voc/tallylight-v2/hardware/TallyLight.kicad_pcb

## KiCad design hardware/TallyLight.kicad_pcb (2026-01-03)

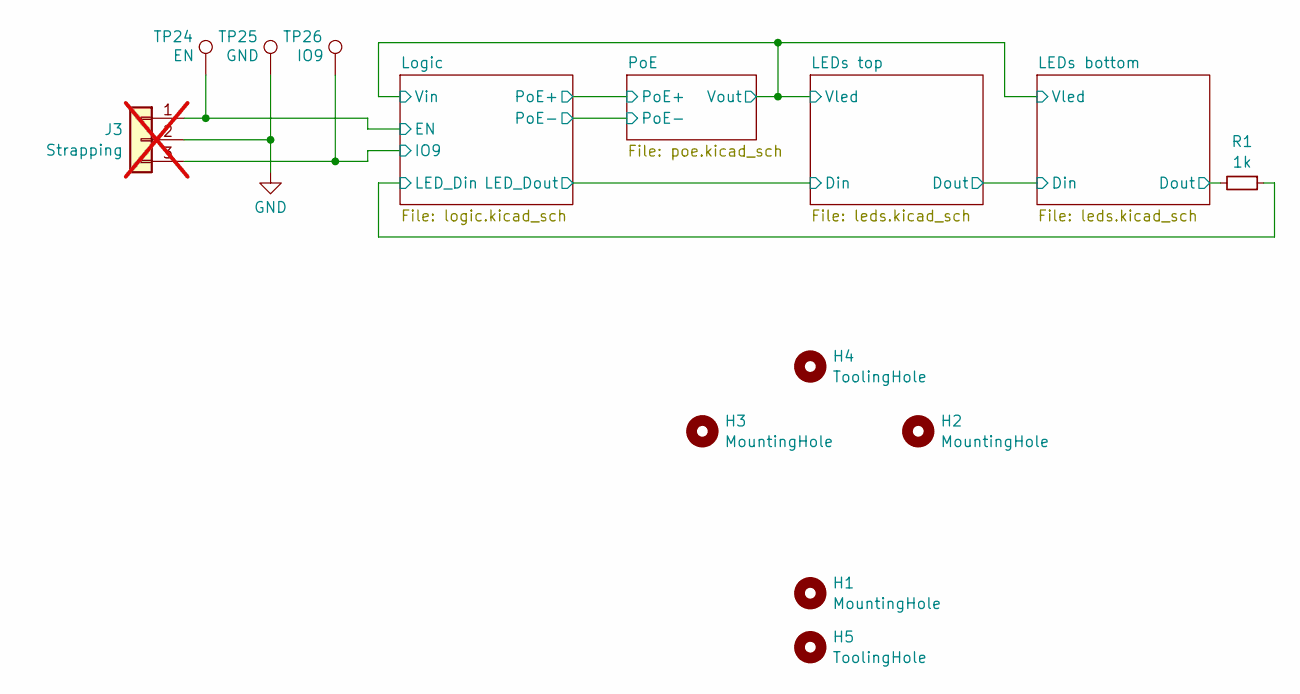
[picture p1: schematic TallyLight.kicad_sch]

Parts:
H1, H2, H3: MountingHole; MountingHole_3.2mm_M3
H4, H5: ToolingHole; ToolingHole_JLCSMT
J3: Strapping; PinHeader_1x03_P2.54mm_Vertical; not fitted
R1: 1k; R_0402_1005Metric; LCSC C11702
TP24: EN; TestPoint_Pad_D2.0mm_no_outline
TP25: GND; TestPoint_Pad_D2.0mm
TP26: IO9; TestPoint_Pad_D2.0mm_no_outline

Connections:
/LEDs bottom/Dout: R1.2; also elsewhere on the board
/Logic/EN: J3.1, TP24.1; also elsewhere on the board
/Logic/IO9: J3.3, TP26.1; also elsewhere on the board
/Logic/LED_Din: R1.1; also elsewhere on the board
GND: J3.2, TP25.1; also elsewhere on the board

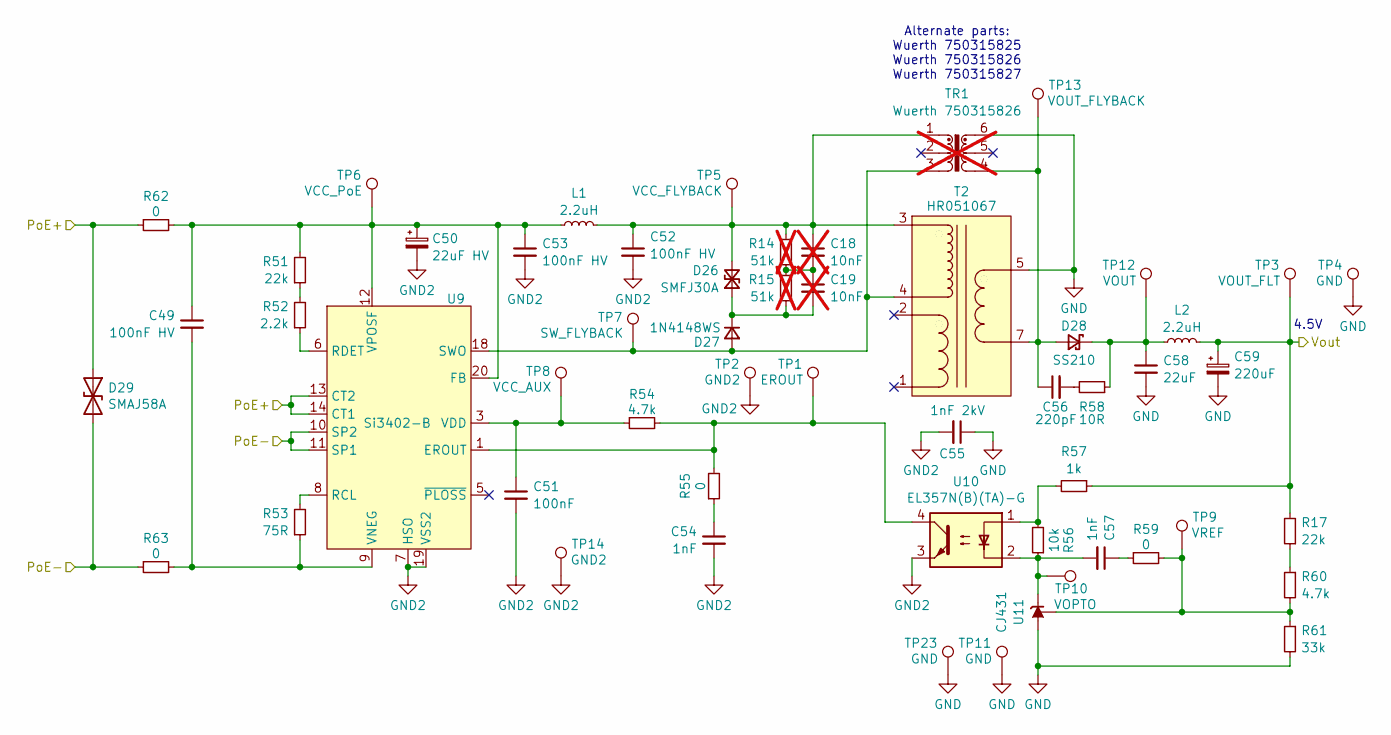
[picture p2: schematic poe.kicad_sch]

Parts:
C18, C19: 10nF; C_0402_1005Metric; LCSC C15195; not fitted
C49, C52, C53: 100nF HV; C_0805_2012Metric; LCSC C28233
C50: 22uF HV; CP_Elec_6.3x7.7; LCSC C344075
C51: 100nF; C_0402_1005Metric; LCSC C1525
C54, C57: 1nF; C_0402_1005Metric; LCSC C1523
C55: 1nF 2kV; C_1206_3216Metric; LCSC C9196
C56: 220pF; C_0402_1005Metric; LCSC C1530
C58: 22uF; C_0805_2012Metric; LCSC C45783
C59: 220uF; CP_Elec_6.3x7.7; LCSC C5243829
D26: SMFJ30A; D_SOD-123F; LCSC C151895
D27: 1N4148WS; D_SOD-323; LCSC C2128
D28: SS210; D_SMA; LCSC C14996
D29: SMAJ58A; D_SMA; LCSC C2980408
L1, L2: 2.2uH; L_1008_2520Metric; LCSC C964122
R14, R15: 51k; R_0402_1005Metric; LCSC C25794; not fitted
R17, R51: 22k; R_0402_1005Metric; LCSC C25768
R52: 2.2k; R_0402_1005Metric; LCSC C25879
R53: 75R; R_0603_1608Metric; LCSC C23242
R54, R60: 4.7k; R_0402_1005Metric; LCSC C25900
R55, R59, R62, R63: 0; R_0402_1005Metric; LCSC C17168
R56: 10k; R_0402_1005Metric; LCSC C25744
R57: 1k; R_0402_1005Metric; LCSC C11702
R58: 10R; R_0402_1005Metric; LCSC C25077
R61: 33k; R_0402_1005Metric; LCSC C25779
T2: HR051067; LCSC C93830
TP1: EROUT; TestPoint_Pad_D2.0mm_no_outline
TP2, TP14: GND2; TestPoint_Pad_D2.0mm_trianglular_outline
TP3: VOUT_FLT; TestPoint_Pad_D2.0mm_no_outline
TP4, TP11, TP23: GND; TestPoint_Pad_D2.0mm
TP5: VCC_FLYBACK; TestPoint_Pad_D2.0mm_no_outline
TP6: VCC_PoE; TestPoint_Pad_D2.0mm_no_outline
TP7: SW_FLYBACK; TestPoint_Pad_D2.0mm_no_outline
TP8: VCC_AUX; TestPoint_Pad_D2.0mm_no_outline
TP9: VREF; TestPoint_Pad_D2.0mm_no_outline
TP10: VOPTO; TestPoint_Pad_D2.0mm_no_outline
TP12: VOUT; TestPoint_Pad_D2.0mm_no_outline
TP13: VOUT_FLYBACK; TestPoint_Pad_D2.0mm_no_outline
TR1: Wuerth 750315826; Transformer_Wuerth_750315371; not fitted
U9: Si3402-B; QFN-20-1EP_5x5mm_P0.8mm_EP2.7x2.7mm; LCSC C510771
U10: EL357N(B)(TA)-G; PC817CS_SMD; LCSC C20612591
U11: CJ431; SOT-23; LCSC C3113

Connections:
/LEDs bottom/Vled: C59.1, L2.2, R17.2, R57.1, TP3.1; also elsewhere on the board
/Logic/PoE+: D29.1 (A1), R62.1, U9.13 (CT2), U9.14 (CT1); also elsewhere on the board
/Logic/PoE-: D29.2 (A2), R63.1, U9.10 (SP2), U9.11 (SP1); also elsewhere on the board
GND: C55.1, C58.2, C59.2, R61.2, T2.5, T2.6, TP4.1, TP11.1, TP23.1, TR1.6, U11.3 (A); also elsewhere on the board
GND2: C50.2, C51.2, C52.2, C53.2, C54.2, C55.2, TP2.1, TP14.1, U9.7 (HSO), U9.19 (VSS2), U10.3
unnamed: C18.2, C19.1, R14.1, R15.2
unnamed: C49.2, R53.1, R63.2, U9.9 (VNEG), U9.21 (VNEG)
unnamed: C54.1, R55.1
unnamed: C56.2, R58.2
unnamed: C57.1, R59.1
unnamed: C19.2, D26.1 (A1), D27.1 (K), R15.1
unnamed: C18.1, C52.1, D26.2 (A2), L1.2, R14.2, T2.3, TP5.1, TR1.1
unnamed: D27.2 (A), T2.4, TP7.1, TR1.3, U9.18 (SWO)
unnamed: C56.1, D28.2 (A), T2.7, T2.8, TP13.1, TR1.4
unnamed: C58.1, D28.1 (K), L2.1, R58.1, TP12.1
unnamed: R17.1, R60.1
unnamed: R51.1, R52.2
unnamed: R56.2, R57.2, U10.1
unnamed: R54.2, R55.2, TP1.1, U9.1 (EROUT), U10.4
unnamed: C49.1, C50.1, C53.1, L1.1, R51.2, R62.2, TP6.1, U9.12 (VPOSF), U9.20 (FB)
unnamed: R53.2, U9.8 (RCL)
unnamed: R52.1, U9.6 (RDET)
unnamed: C51.1, R54.1, TP8.1, U9.3 (VDD)
unnamed: C57.2, R56.1, TP10.1, U10.2, U11.2 (K)
unnamed: R59.2, R60.2, R61.1, TP9.1, U11.1 (REF)

Notes on the sheet:
4.5V
Alternate parts: Wuerth 750315825 Wuerth 750315826 Wuerth 750315827

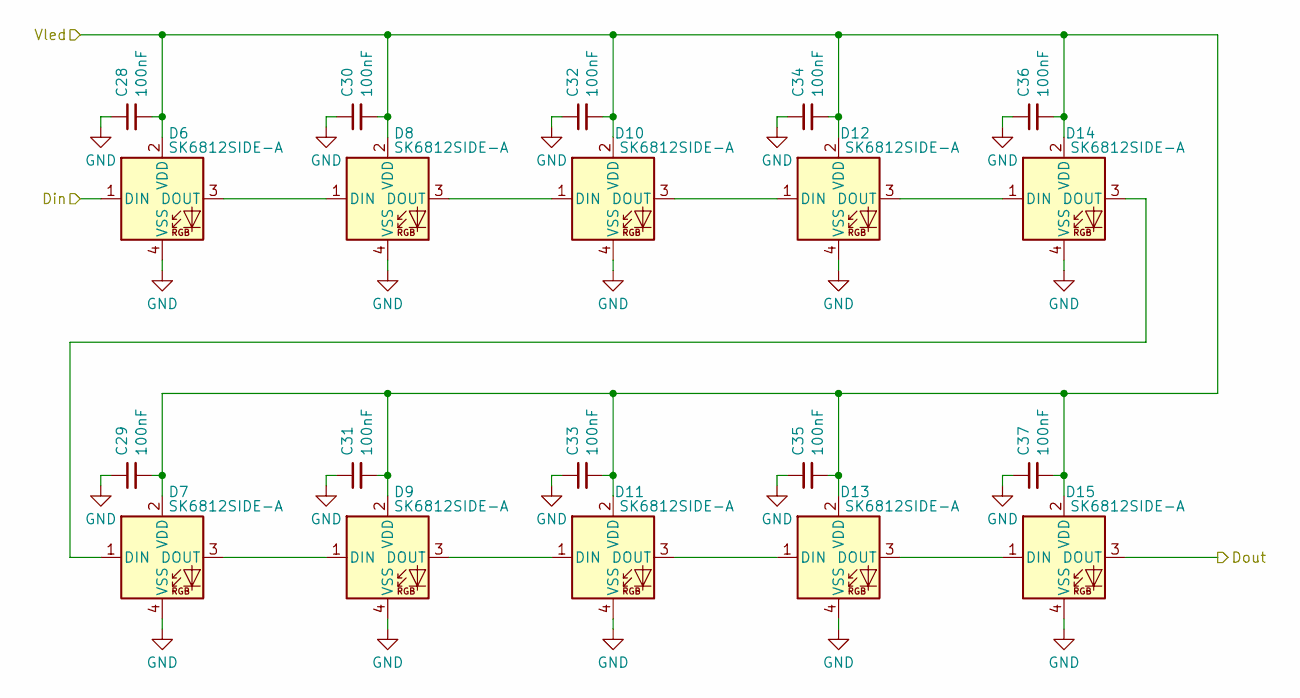
[picture p3: schematic leds.kicad_sch]

Parts:
C28, C29, C30, C31, C32, C33, C34, C35, C36, C37: 100nF; C_0402_1005Metric; LCSC C1525
D6, D7, D8, D9, D10, D11, D12, D13, D14, D15: SK6812SIDE-A; LED_SK6812SIDE-A; LCSC C5378721

Connections:
/LEDs bottom/Din: D15.3 (DOUT); also elsewhere on the board
/LEDs bottom/Vled: C28.2, C29.2, C30.2, C31.2, C32.2, C33.2, C34.2, C35.2, C36.2, C37.2, D6.2 (VDD), D7.2 (VDD), D8.2 (VDD), D9.2 (VDD), D10.2 (VDD), D11.2 (VDD), D12.2 (VDD), D13.2 (VDD), D14.2 (VDD), D15.2 (VDD); also elsewhere on the board
/LEDs top/Din: D6.1 (DIN); also elsewhere on the board
GND: C28.1, C29.1, C30.1, C31.1, C32.1, C33.1, C34.1, C35.1, C36.1, C37.1, D6.4 (VSS), D7.4 (VSS), D8.4 (VSS), D9.4 (VSS), D10.4 (VSS), D11.4 (VSS), D12.4 (VSS), D13.4 (VSS), D14.4 (VSS), D15.4 (VSS); also elsewhere on the board
unnamed: D6.3 (DOUT), D8.1 (DIN)
unnamed: D7.3 (DOUT), D9.1 (DIN)
unnamed: D8.3 (DOUT), D10.1 (DIN)
unnamed: D10.3 (DOUT), D12.1 (DIN)
unnamed: D9.3 (DOUT), D11.1 (DIN)
unnamed: D11.3 (DOUT), D13.1 (DIN)
unnamed: D12.3 (DOUT), D14.1 (DIN)
unnamed: D13.3 (DOUT), D15.1 (DIN)
unnamed: D7.1 (DIN), D14.3 (DOUT)

Parts of its further copies:
C38, C39, C40, C41, C42, C43, C44, C45, C46, C47: 100nF; C_0402_1005Metric; LCSC C1525
D16, D17, D18, D19, D20, D21, D22, D23, D24, D25: SK6812SIDE-A; LED_SK6812SIDE-A; LCSC C5378721

Connections of its further copies:
/LEDs bottom/Din: D16.1 (DIN); also elsewhere on the board
/LEDs bottom/Dout: D25.3 (DOUT); also elsewhere on the board
/LEDs bottom/Vled: C38.2, C39.2, C40.2, C41.2, C42.2, C43.2, C44.2, C45.2, C46.2, C47.2, D16.2 (VDD), D17.2 (VDD), D18.2 (VDD), D19.2 (VDD), D20.2 (VDD), D21.2 (VDD), D22.2 (VDD), D23.2 (VDD), D24.2 (VDD), D25.2 (VDD); also elsewhere on the board
GND: C38.1, C39.1, C40.1, C41.1, C42.1, C43.1, C44.1, C45.1, C46.1, C47.1, D16.4 (VSS), D17.4 (VSS), D18.4 (VSS), D19.4 (VSS), D20.4 (VSS), D21.4 (VSS), D22.4 (VSS), D23.4 (VSS), D24.4 (VSS), D25.4 (VSS); also elsewhere on the board
unnamed: D16.3 (DOUT), D18.1 (DIN)
unnamed: D17.1 (DIN), D24.3 (DOUT)
unnamed: D17.3 (DOUT), D19.1 (DIN)
unnamed: D18.3 (DOUT), D20.1 (DIN)
unnamed: D19.3 (DOUT), D21.1 (DIN)
unnamed: D20.3 (DOUT), D22.1 (DIN)
unnamed: D21.3 (DOUT), D23.1 (DIN)
unnamed: D22.3 (DOUT), D24.1 (DIN)
unnamed: D23.3 (DOUT), D25.1 (DIN)

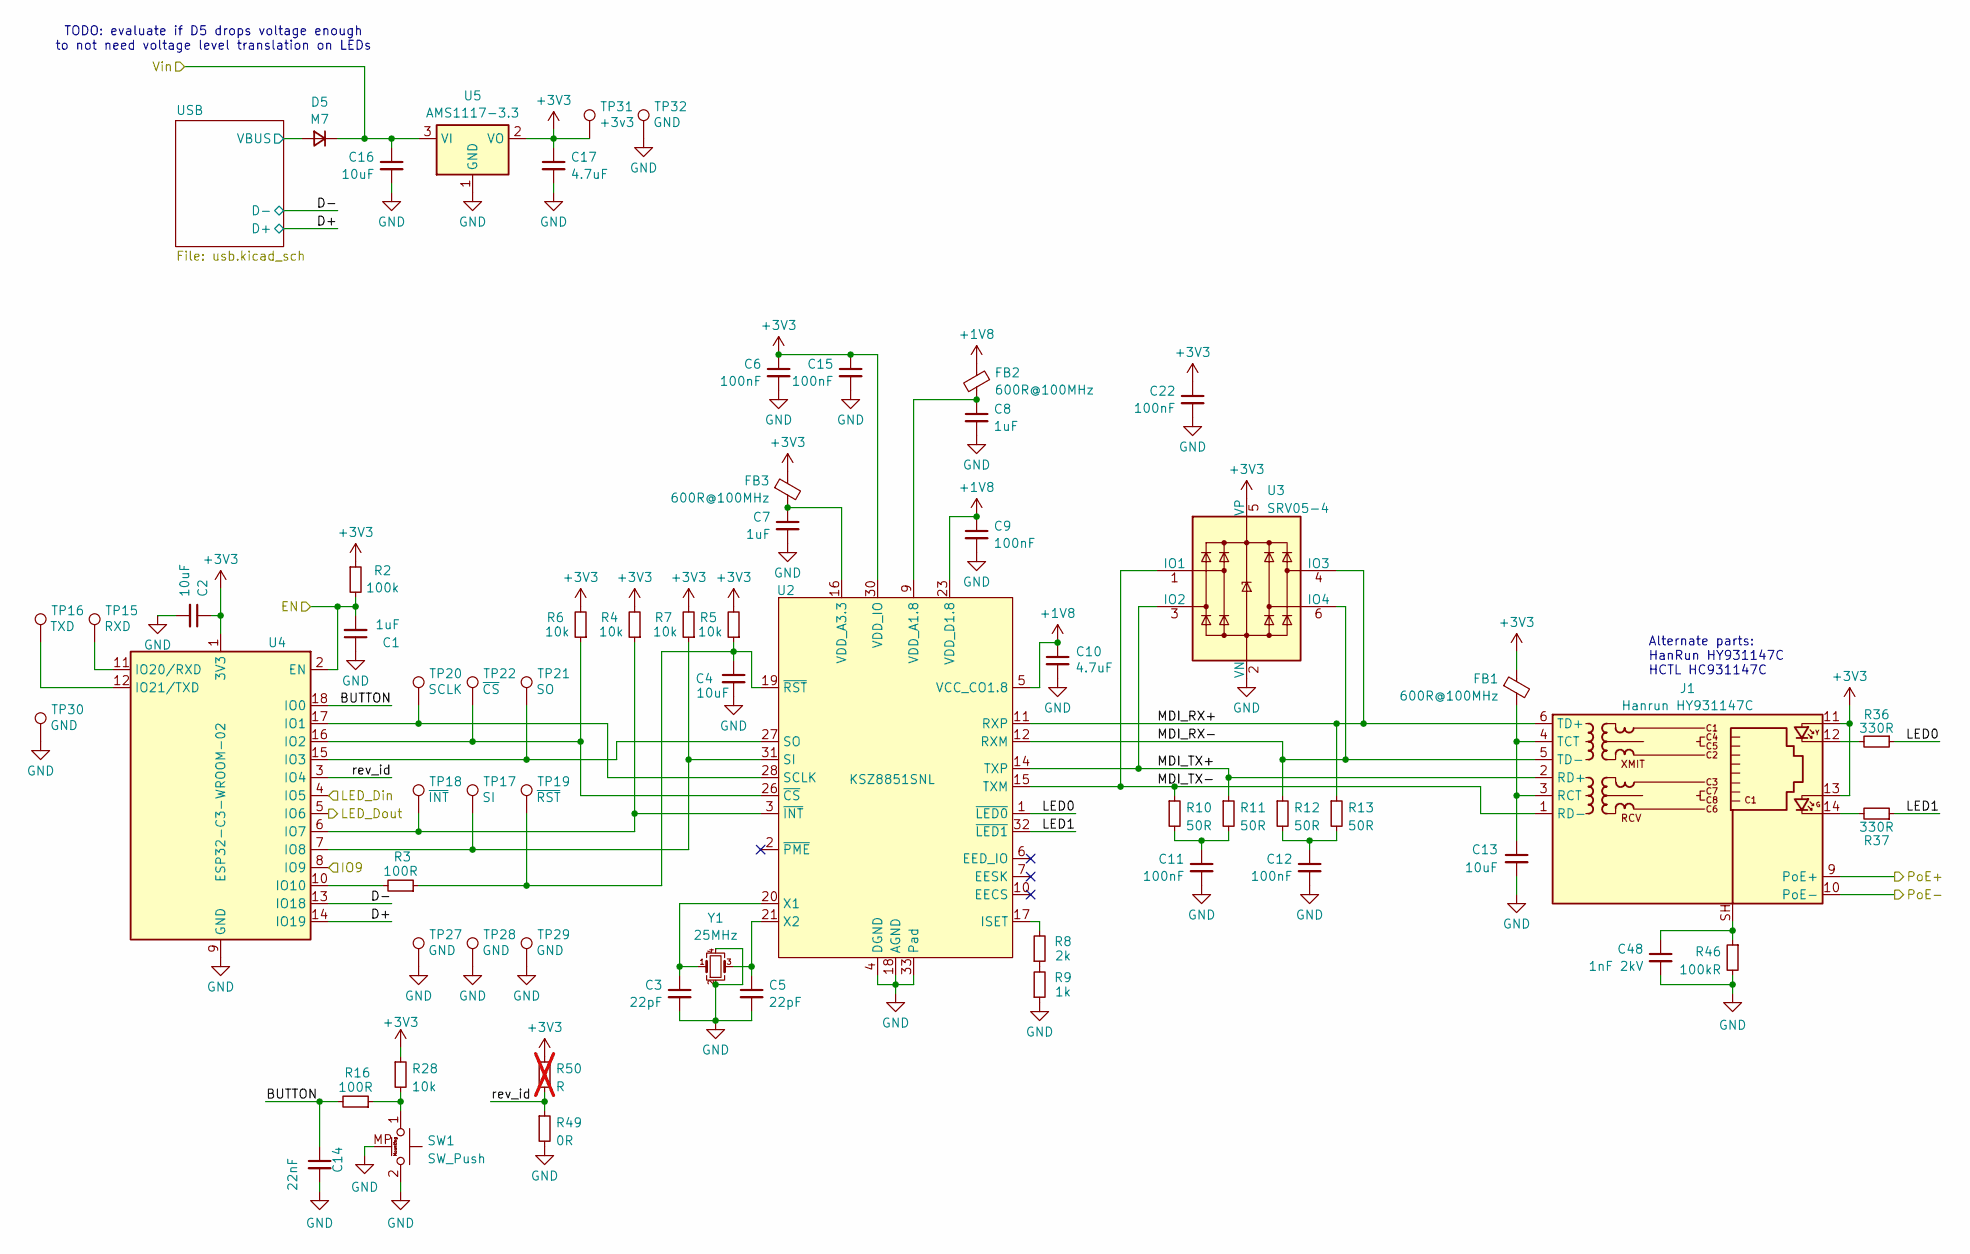
[picture p4: schematic logic.kicad_sch]

Parts:
C1, C7, C8: 1uF; C_0402_1005Metric; LCSC C52923
C2, C4, C13: 10uF; C_0402_1005Metric; LCSC C15525
C3, C5: 22pF; C_0402_1005Metric; LCSC C1555
C6, C9, C11, C12, C15, C22: 100nF; C_0402_1005Metric; LCSC C1525
C10, C17: 4.7uF; C_0402_1005Metric; LCSC C23733
C14: 22nF; C_0402_1005Metric; LCSC C1532
C16: 10uF; C_0603_1608Metric; LCSC C96446
C48: 1nF 2kV; C_1206_3216Metric; LCSC C9196
D5: M7; D_SMA; LCSC C95872
FB1, FB2, FB3: 600R@100MHz; L_0402_1005Metric; LCSC C76884
J1: Hanrun HY931147C; RJ45_Hanrun_HY931147C_Horizontal; LCSC C3021372
R2: 100k; R_0402_1005Metric; LCSC C25741
R3, R16: 100R; R_0402_1005Metric; LCSC C25076
R4, R5, R6, R7, R28: 10k; R_0402_1005Metric; LCSC C25744
R8: 2k; R_0402_1005Metric; LCSC C4109
R9: 1k; R_0402_1005Metric; LCSC C11702
R10, R11, R12, R13: 50R; R_0402_1005Metric; LCSC C25120
R36, R37: 330R; R_0402_1005Metric; LCSC C25104
R46: 100kR; R_1206_3216Metric; LCSC C17900
R49: 0R; R_0402_1005Metric; LCSC C17168
R50: R; R_0402_1005Metric; not fitted
SW1: SW_Push; KEY-TH_4P-L7.5-W6.8-P4.50-LS7.2; LCSC C266183
TP15: RXD; TestPoint_Pad_D2.0mm_no_outline
TP16: TXD; TestPoint_Pad_D2.0mm_no_outline
TP17: SI; TestPoint_Pad_D2.0mm_no_outline
TP18: ~{INT}; TestPoint_Pad_D2.0mm_no_outline
TP19: ~{RST}; TestPoint_Pad_D2.0mm_no_outline
TP20: SCLK; TestPoint_Pad_D2.0mm_no_outline
TP21: SO; TestPoint_Pad_D2.0mm_no_outline
TP22: ~{CS}; TestPoint_Pad_D2.0mm_no_outline
TP27, TP28, TP29, TP30, TP32: GND; TestPoint_Pad_D2.0mm
TP31: +3v3; TestPoint_Pad_D2.0mm_no_outline
U2: KSZ8851SNL; QFN-32-1EP_5x5mm_P0.5mm_EP3.1x3.1mm_ThermalVias; LCSC C633272
U3: SRV05-4; SOT-23-6; LCSC C85364
U4: ESP32-C3-WROOM-02; LCSC C2934560
U5: AMS1117-3.3; SOT-223-3_TabPin2; LCSC C6186
Y1: 25MHz; Crystal_SMD_3225-4Pin_3.2x2.5mm; LCSC C9006

Connections:
+1V8: C9.1, C10.1, FB2.1, U2.5 (VCC_CO1.8), U2.23 (VDD_D1.8)
+3V3: C2.1, C6.1, C15.1, C17.1, C22.1, FB1.1, FB3.1, J1.11, J1.13, R2.1, R4.2, R5.2, R6.2, R7.2, R28.1, R50.1, TP31.1, U2.25 (VDD_IO), U2.30 (VDD_IO), U3.5 (VP), U4.1 (3V3), U5.2 (VO); also elsewhere on the board
/LEDs bottom/Vled: C16.1, D5.1 (K), U5.3 (VI); also elsewhere on the board
/LEDs top/Din: U4.5 (IO6); also elsewhere on the board
/Logic/BUTTON: C14.1, R16.2, U4.18 (IO0)
/Logic/D+: U4.14 (IO19); also elsewhere on the board
/Logic/D-: U4.13 (IO18); also elsewhere on the board
/Logic/EN: C1.2, R2.2, U4.2 (EN); also elsewhere on the board
/Logic/IO9: U4.8 (IO9); also elsewhere on the board
/Logic/LED0: R36.1, U2.1 (~LED0)
/Logic/LED1: R37.1, U2.32 (~LED1)
/Logic/LED_Din: U4.4 (IO5); also elsewhere on the board
/Logic/MDI_RX+: J1.6 (TD+), R13.1, U2.11 (RXP), U3.4 (IO3)
/Logic/MDI_RX-: J1.5 (TD-), R12.1, U2.12 (RXM), U3.6 (IO4)
/Logic/MDI_TX+: J1.2 (RD+), R11.1, U2.14 (TXP), U3.3 (IO2)
/Logic/MDI_TX-: J1.1 (RD-), R10.1, U2.15 (TXM), U3.1 (IO1)
/Logic/PoE+: J1.9 (PoE+); also elsewhere on the board
/Logic/PoE-: J1.10 (PoE-); also elsewhere on the board
/Logic/USB/VBUS: D5.2 (A); also elsewhere on the board
/Logic/rev_id: R49.1, R50.2, U4.3 (IO4)
GND: C1.1, C2.2, C3.2, C4.2, C5.2, C6.2, C7.2, C8.2, C9.2, C10.2, C11.2, C12.2, C13.2, C14.2, C15.2, C16.2, C17.2, C22.2, C48.2, R9.1, R46.2, R49.2, SW1.2, SW1.MP, TP27.1, TP28.1, TP29.1, TP30.1, TP32.1, U2.4 (DGND), U2.8 (AGND), U2.13 (AGND), U2.18 (AGND), U2.22 (DGND), U2.24 (DGND), U2.29 (DGND), U2.33 (Pad), U3.2 (VN), U4.9 (GND), U4.19 (GND), U5.1 (GND), Y1.2, Y1.4; also elsewhere on the board
unnamed: C11.1, R10.2, R11.2
unnamed: C12.1, R12.2, R13.2
unnamed: C48.1, J1.SH, R46.1
unnamed: J1.12, R36.2
unnamed: J1.14, R37.2
unnamed: C13.1, FB1.2, J1.3 (RCT), J1.4 (TCT)
unnamed: R8.1, R9.2
unnamed: R16.1, R28.2, SW1.1
unnamed: R8.2, U2.17 (ISET)
unnamed: TP20.1, U2.28 (SCLK), U4.17 (IO1)
unnamed: R7.1, TP17.1, U2.31 (SI), U4.7 (IO8)
unnamed: TP21.1, U2.27 (SO), U4.15 (IO3)
unnamed: C8.1, FB2.2, U2.9 (VDD_A1.8)
unnamed: C7.1, FB3.2, U2.16 (VDD_A3.3)
unnamed: C3.1, U2.20 (X1), Y1.1
unnamed: C5.1, U2.21 (X2), Y1.3
unnamed: R6.1, TP22.1, U2.26 (~CS), U4.16 (IO2)
unnamed: R4.1, TP18.1, U2.3 (~INT), U4.6 (IO7)
unnamed: C4.1, R3.1, R5.1, TP19.1, U2.19 (~RST)
unnamed: R3.2, U4.10 (IO10)
unnamed: TP15.1, U4.11 (IO20/RXD)
unnamed: TP16.1, U4.12 (IO21/TXD)

Notes on the sheet:
Alternate parts: HanRun HY931147C HCTL HC931147C
TODO: evaluate if D5 drops voltage enough to not need voltage level translation on LEDs

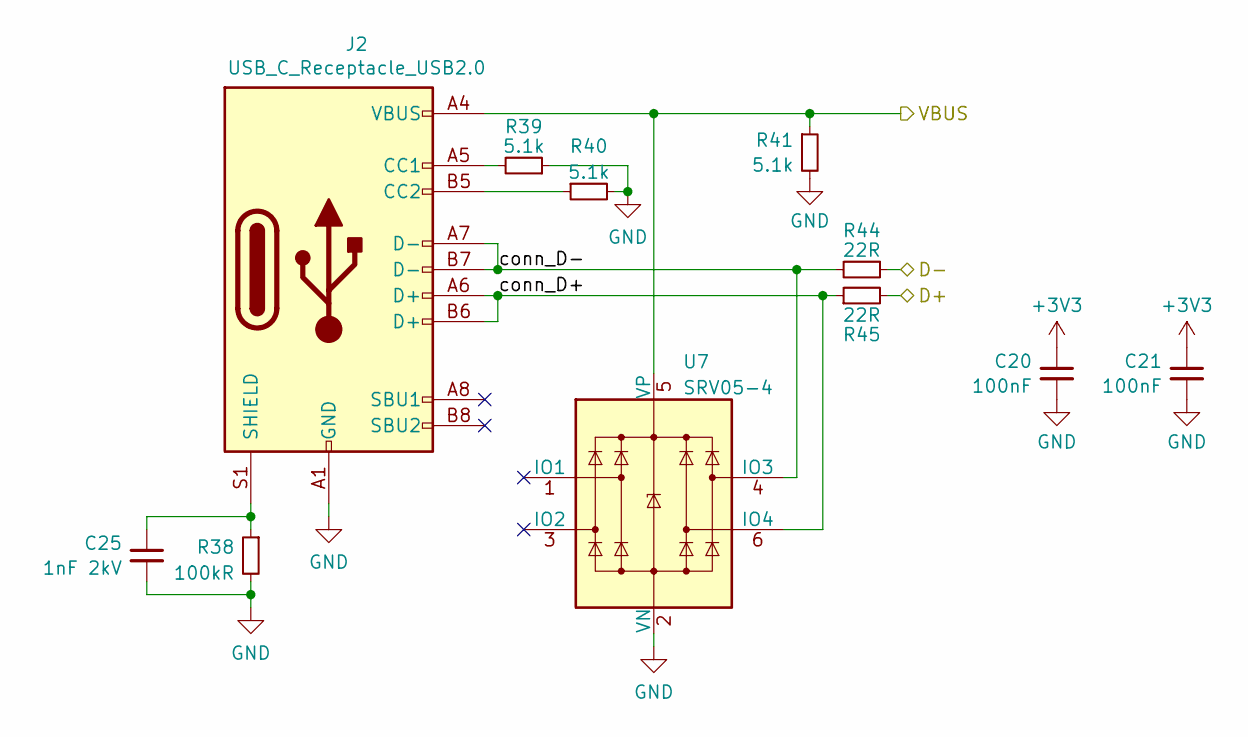
[picture p5: schematic usb.kicad_sch]

Parts:
C20, C21: 100nF; C_0402_1005Metric; LCSC C1525
C25: 1nF 2kV; C_1206_3216Metric; LCSC C9196
J2: USB_C_Receptacle_USB2.0; USB_C_Receptacle_Palconn_UTC16-G; LCSC C167321
R38: 100kR; R_1206_3216Metric; LCSC C17900
R39, R40, R41: 5.1k; R_0402_1005Metric; LCSC C25905
R44, R45: 22R; R_0402_1005Metric; LCSC C25092
U7: SRV05-4; SOT-23-6; LCSC C85364

Connections:
+3V3: C20.1, C21.1; also elsewhere on the board
/Logic/D+: R45.2; also elsewhere on the board
/Logic/D-: R44.1; also elsewhere on the board
/Logic/USB/VBUS: J2.A4 (VBUS), J2.A9 (VBUS), J2.B4 (VBUS), J2.B9 (VBUS), R41.1, U7.5 (VP); also elsewhere on the board
/Logic/USB/conn_D+: J2.A6 (D+), J2.B6 (D+), R45.1, U7.6 (IO4)
/Logic/USB/conn_D-: J2.A7 (D-), J2.B7 (D-), R44.2, U7.4 (IO3)
GND: C20.2, C21.2, C25.2, J2.A1 (GND), J2.A12 (GND), J2.B1 (GND), J2.B12 (GND), R38.2, R39.1, R40.2, R41.2, U7.2 (VN); also elsewhere on the board
unnamed: J2.A5 (CC1), R39.2
unnamed: J2.B5 (CC2), R40.1
unnamed: C25.1, J2.S1 (SHIELD), R38.1

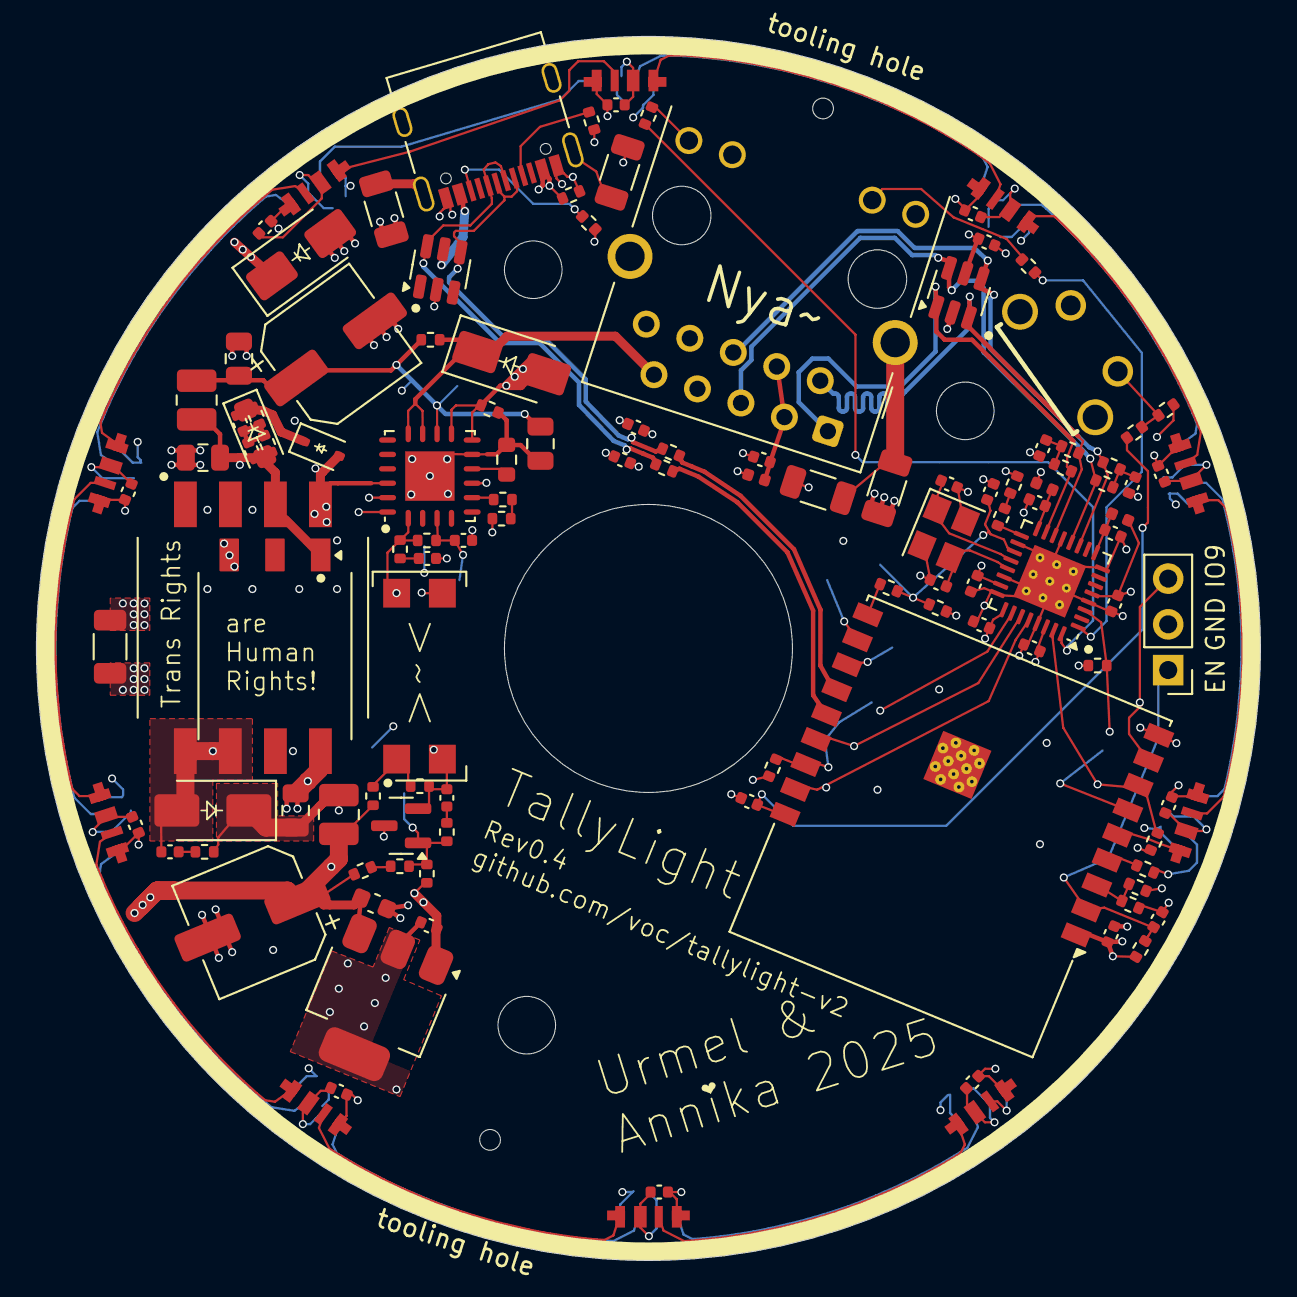
[picture p6: board TallyLight.kicad_pcb from above]

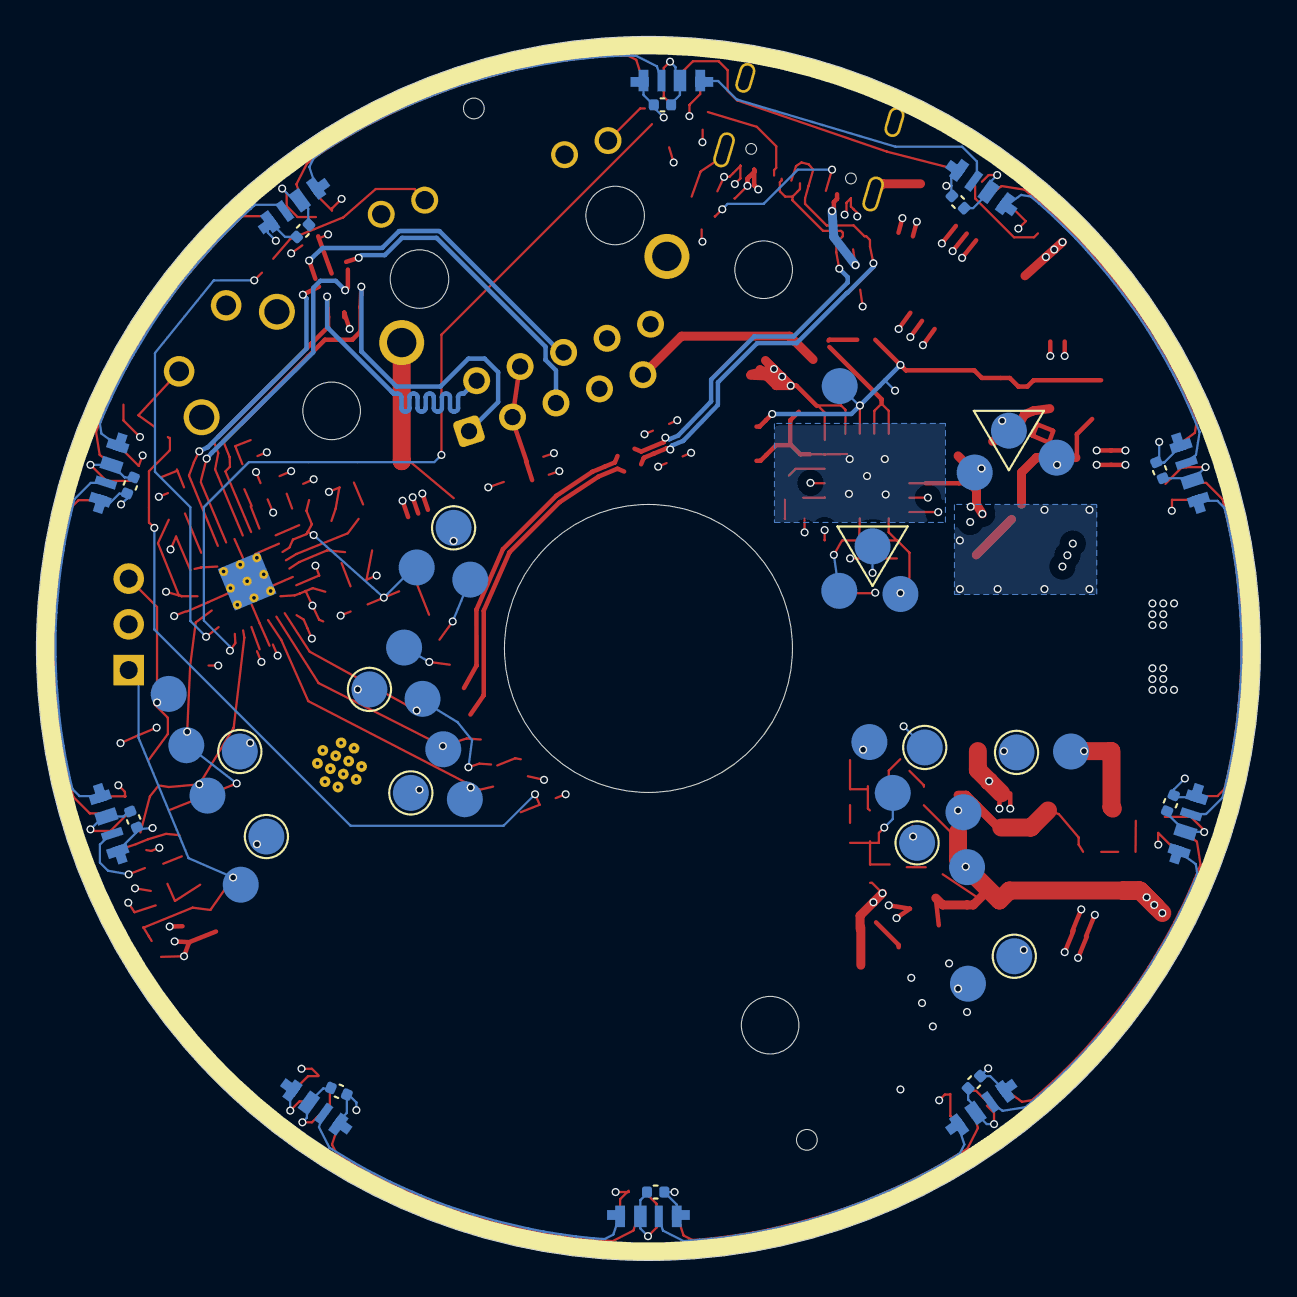
[picture p7: board TallyLight.kicad_pcb from below]

Board: 4 copper layers, 68.0 x 68.0 mm, 179 parts (52 on the bottom side), 89 nets.
