voc/tallylight-v2/(commit log)

2025-02-13 Add initial rev0 schematic and layout
    First rough draft
    [TallyLight.kicad_pcb, TallyLight.kicad_sch, leds.kicad_sch, logic.kicad_sch, poe.kicad_sch, usb.kicad_sch]
2025-02-13 Add OpenSCAD crime^w°winitial case design
    [tally_light_case.scad]
2025-03-02 hardware: case: add transparent ring to improve light transmission
    [tally_light_case.scad]
2025-03-02 hardware: switch to ESP32-C3 MCU and Si3402-B for PoE
    Further changes:
    - Enlarge center hole to 16mm diameter
    - Replace Ethernet Phy by KSZ8851 SPI MAC + Phy
    [TallyLight.kicad_pcb, TallyLight.kicad_sch, logic.kicad_sch, poe.kicad_sch, usb.kicad_sch]
2025-03-02 hardware: add missing pin 1 indicator to optocoupler U10
    [TallyLight.kicad_pcb]
2025-03-02 hardware: replace ESP32-C3 MINI by more common WROOM-02 module
    [TallyLight.kicad_pcb, logic.kicad_sch, poe.kicad_sch]
2025-03-02 hardware: add testpoints to flyback converter and SPI MAC + Phy
    Add testpoints to all critical section that might require in-circuit
    debugging
    [TallyLight.kicad_pcb, TallyLight.kicad_sch, logic.kicad_sch, poe.kicad_sch]
2025-03-02 hardware: add small thermal plane to PoE controller
    [TallyLight.kicad_pcb]
2025-03-02 hardware: pull up GPIO2
    There is a bit of an ominous sentence in the ESP32-C3 datasheet:
    "GPIO2 actually does not determine SPI Boot and Joint Download Boot mode,
    but it is recommended to pull this pin up due to glitches."
    Switch GPIO2 to an input pin on the KSZ8851 and pull it up to VDD to avoid
    any possible issues.
    [TallyLight.kicad_pcb, logic.kicad_sch]
2025-03-02 hardware: add alternate snubber and flyback footprints
    [TallyLight.kicad_pcb, poe.kicad_sch]
2025-03-02 hardware: add LCSC partnumber to ESP32-C3 module
    [TallyLight.kicad_pcb, logic.kicad_sch, poe.kicad_sch]
2025-03-02 hardware: upgrade decoupling caps on ferrite beads to 1µF
    [TallyLight.kicad_pcb, logic.kicad_sch]
2025-03-19 Implement review comments by Urmel
    [TallyLight.kicad_pcb, logic.kicad_sch, poe.kicad_sch, usb.kicad_sch]
2025-03-20 Make button trace around center hole more round
    [TallyLight.kicad_pcb]
2025-03-22 Exclude parts with virtual footprints from BOM
    [TallyLight.kicad_sch, logic.kicad_sch, poe.kicad_sch]
2025-03-22 Exclude bottom side LEDs and associated passives from position file
    [TallyLight.kicad_pcb]
2025-03-22 Add full size quater inch insert support column
    [tally_light_case.scad]
2025-04-11 Optimize flyback feedback loop stability
    During load testing on an initial prototype better component values for the
    flyback feedback loop were found. Update design with those.
    [TallyLight.kicad_pcb, poe.kicad_sch]
2025-04-21 Improve heatsinking on secondary side flyback rectifier diode
    The diode can get a bit hot under high load.
    Improve its cooling.
    [TallyLight.kicad_pcb]
2025-12-31 rev 0.4 move button next to ethernet jack, kicad v9
    [TallyLight.kicad_pcb, TallyLight.kicad_sch, leds.kicad_sch, logic.kicad_sch, poe.kicad_sch, usb.kicad_sch]
2025-12-31 Update button footprint library reference
    The library symbol was previously changed in the PCB design file only.
    Reflect that change in the schematic, too.
    [logic.kicad_sch]
2025-12-31 Remove stubs from Ethernet TVS
    [TallyLight.kicad_pcb]
2026-01-03 update button lcsc part to shorter variant
    [TallyLight.kicad_pcb]
